tasmaniandroid/Philly_Node/Philly_Node_Lib/DRV0006A.stp

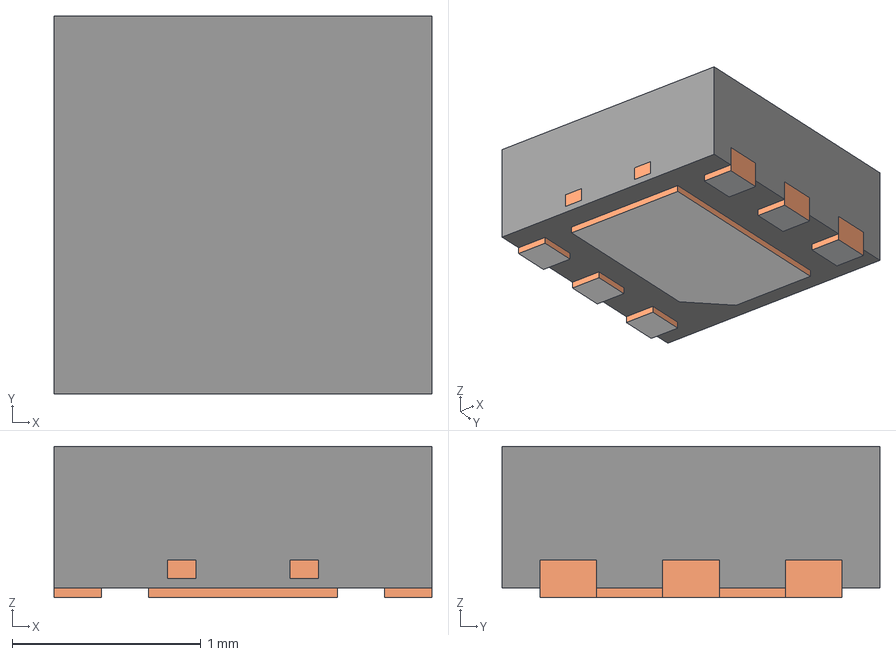
[picture p1: CAD file, 2026-02-25]
Philly_Node_Lib/DRV0006A.stp
2.00 x 2.00 x 0.8 mm
BODY-SON
FRAME-DRV0006A
PIN1-ID
