tasmaniandroid/Philly_Node/Philly_Node_Lib/CC7V-T1A-32.768KHZ-7PF-100PPM-TA-QC.STEP

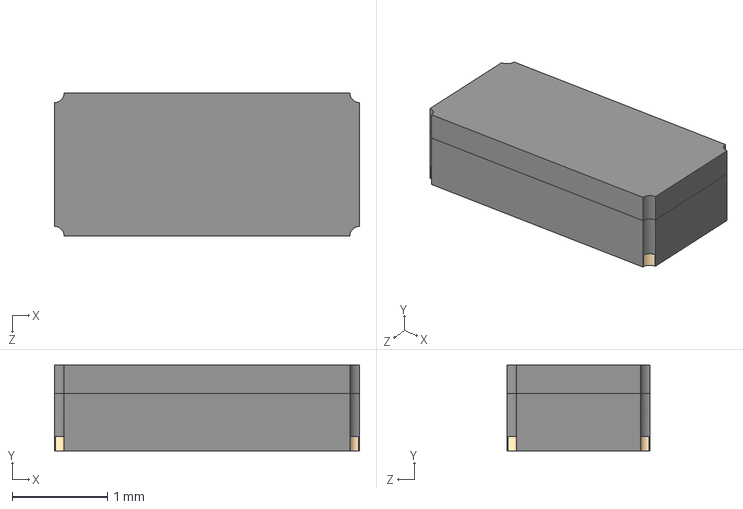
[picture p2: CAD file, 2026-02-14]
Philly_Node_Lib/CC7V-T1A-32.768KHZ-7PF-100PPM-TA-QC.STEP
3.20 x 0.9 x 1.50 mm
