tasmaniandroid/Philly_Node/Philly_Node_Lib/WIRELM-SMD_E22-900M22S.step

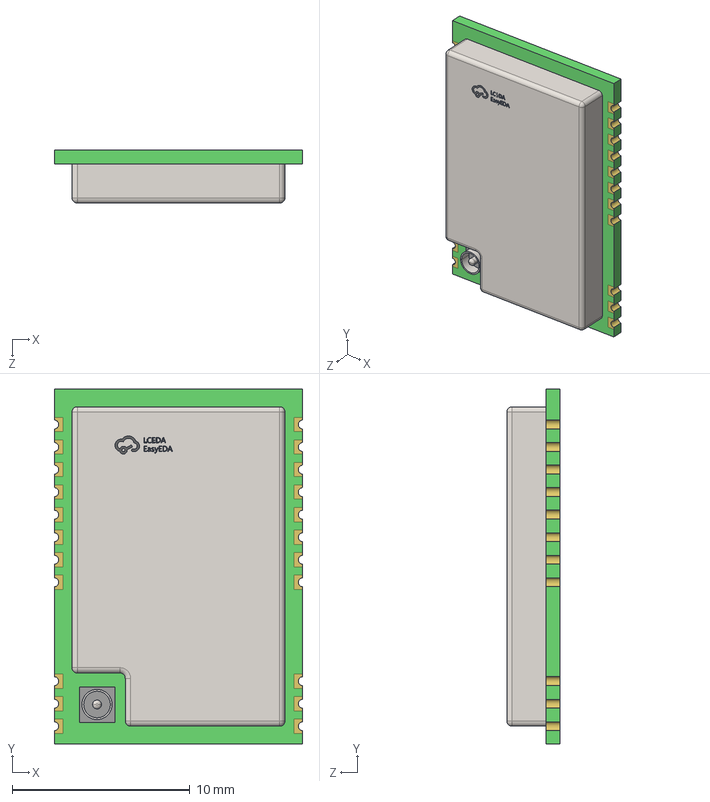
[picture p3: CAD file, 2026-02-14]
Philly_Node_Lib/WIRELM-SMD_E22-900M22S.step
14.0 x 20.0 x 3.00 mm
