tasmaniandroid/Philly_Node/Philly_Node_Lib/LIS2DW12TR.step

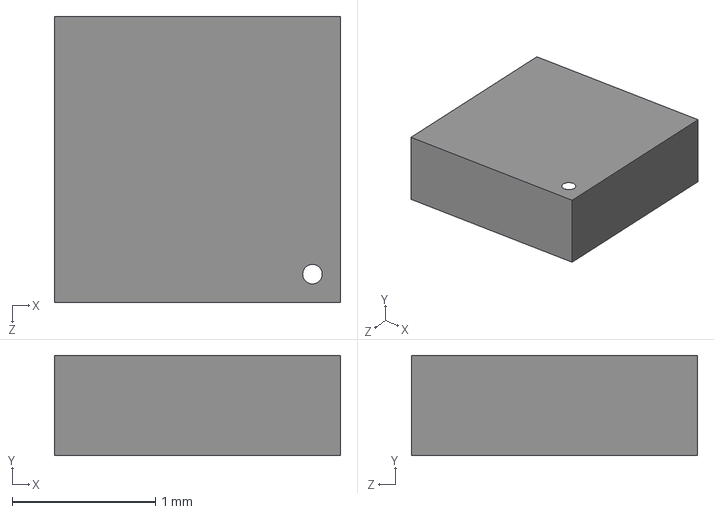
[picture p4: CAD file, 2026-02-14]
Philly_Node_Lib/LIS2DW12TR.step
2.00 x 0.7 x 2.00 mm
