tasmaniandroid/Philly_Node/Philly_Node_Lib/TL3301EF160QJ.stp

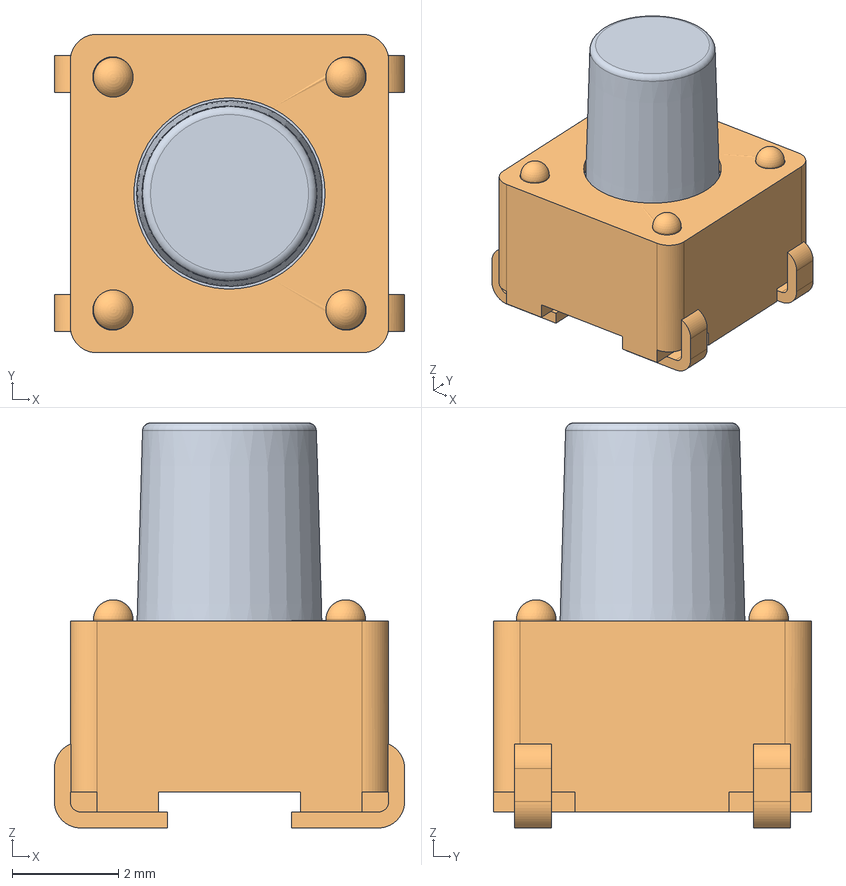
[picture p5: CAD file, 2026-02-14]
Philly_Node_Lib/TL3301EF160QJ.stp
6.60 x 6.00 x 7.63 mm
