tasmaniandroid/Philly_Node/Philly_Node_Lib/F52Q-1A7H1-11020.step

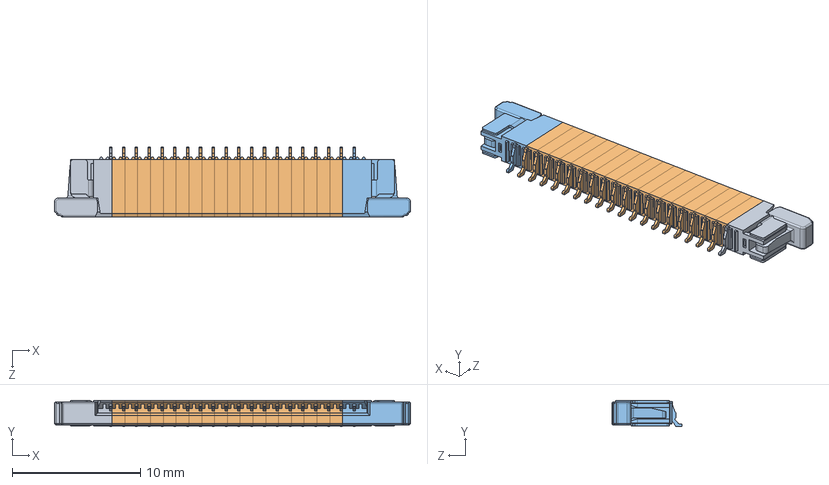
[picture p6: CAD file, 2026-02-14]
Philly_Node_Lib/F52Q-1A7H1-11020.step
27.8 x 2.05 x 5.50 mm
F52Q_L.STEP
F52Q_M.STEP x 18
F52Q_R.STEP
