tasmaniandroid/Philly_Node/Philly_Node_Lib/MDBT50Q-U 3D Drawing_20180620.stp

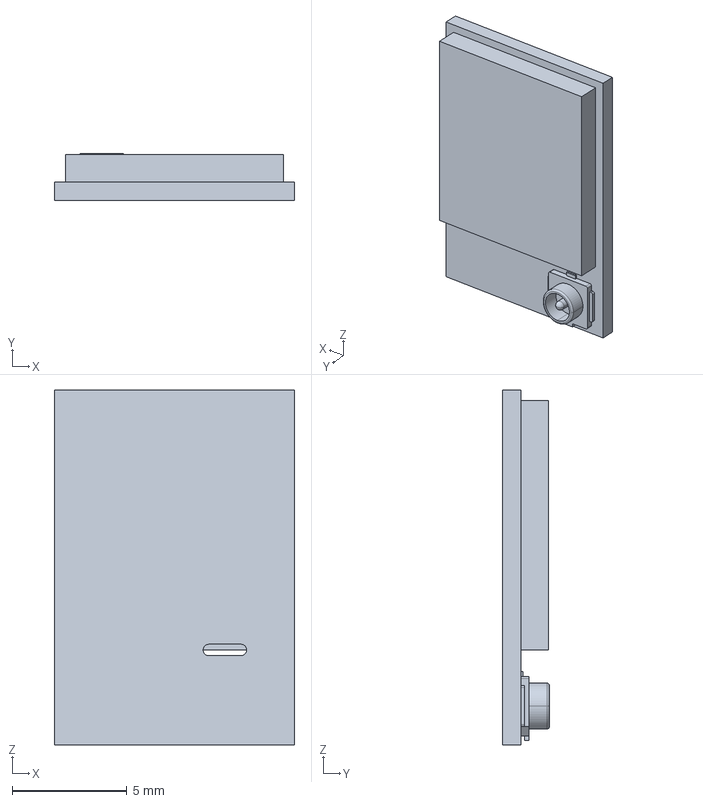
[picture p7: CAD file, 2026-02-14]
Philly_Node_Lib/MDBT50Q-U 3D Drawing_20180620.stp
10.5 x 2.05 x 15.5 mm
