tasmaniandroid/Philly_Node/Philly_Node_Lib/USB4110-GF-A.STEP

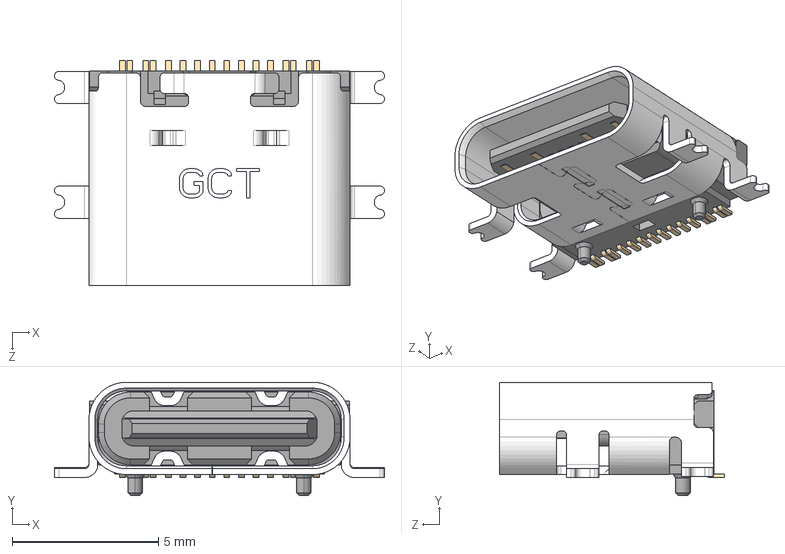
[picture p8: CAD file, 2026-02-14]
Philly_Node_Lib/USB4110-GF-A.STEP
11.3 x 3.89 x 7.70 mm
