tasmaniandroid/Philly_Node/Philly_Node_Lib/XF3M_1_0415_1B.stp

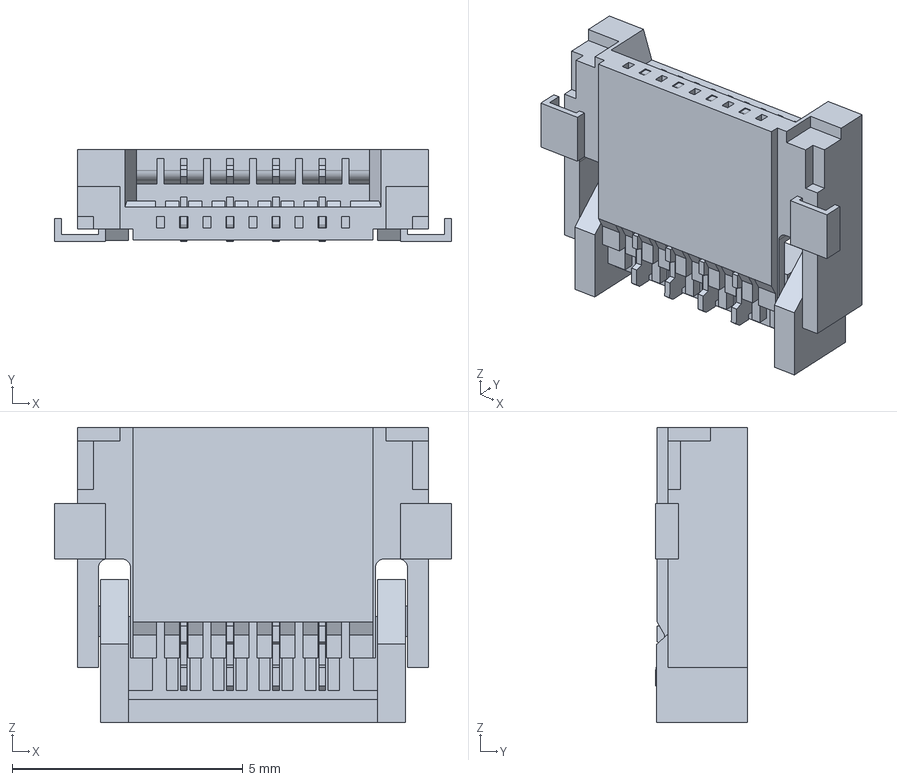
[picture p9: CAD file, 2026-02-14]
Philly_Node_Lib/XF3M_1_0415_1B.stp
8.60 x 2.00 x 6.40 mm
