tasmaniandroid/Philly_Node/Philly_Node_Lib/S2B-PH-SM4-TB.STEP

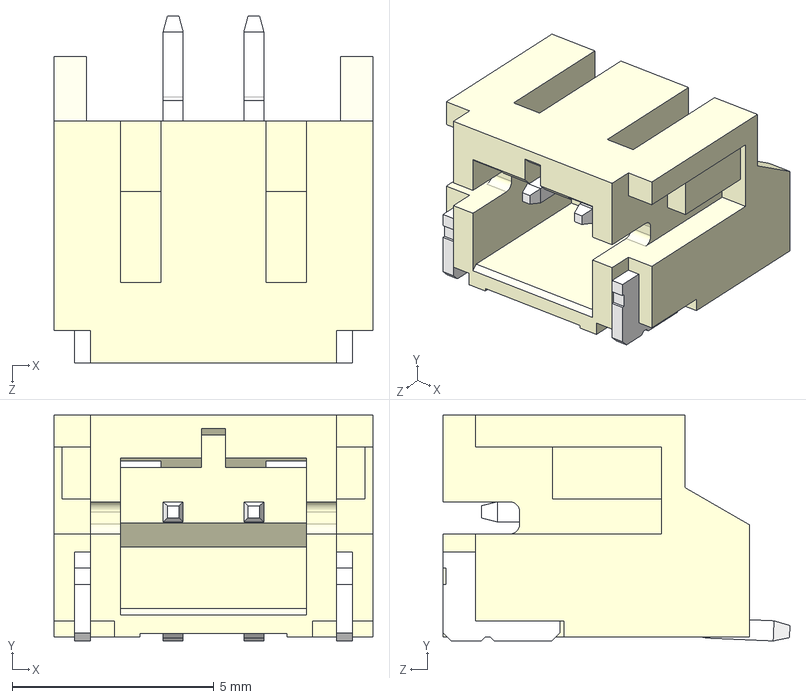
[picture p10: CAD file, 2026-02-14]
Philly_Node_Lib/S2B-PH-SM4-TB.STEP
7.90 x 5.60 x 8.60 mm
