tasmaniandroid/Philly_Node/Philly_Node_Lib/SOD-523_L1.2-W0.8-LS1.6-BI.step

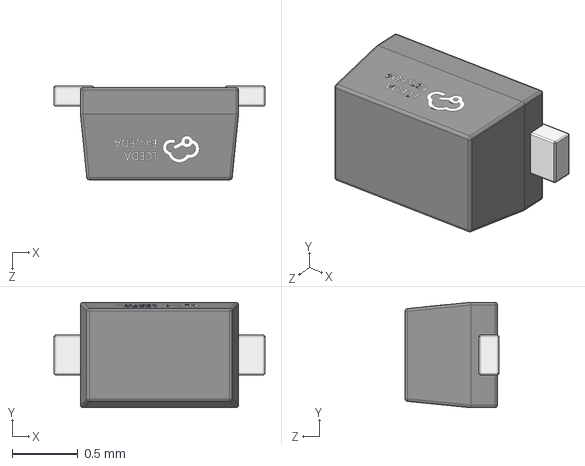
[picture p11: CAD file, 2026-02-14]
Philly_Node_Lib/SOD-523_L1.2-W0.8-LS1.6-BI.step
1.60 x 0.8 x 0.71 mm
