tasmaniandroid/Philly_Node/Philly_Node_Lib/CWJ1.8F160RGBQ.stp

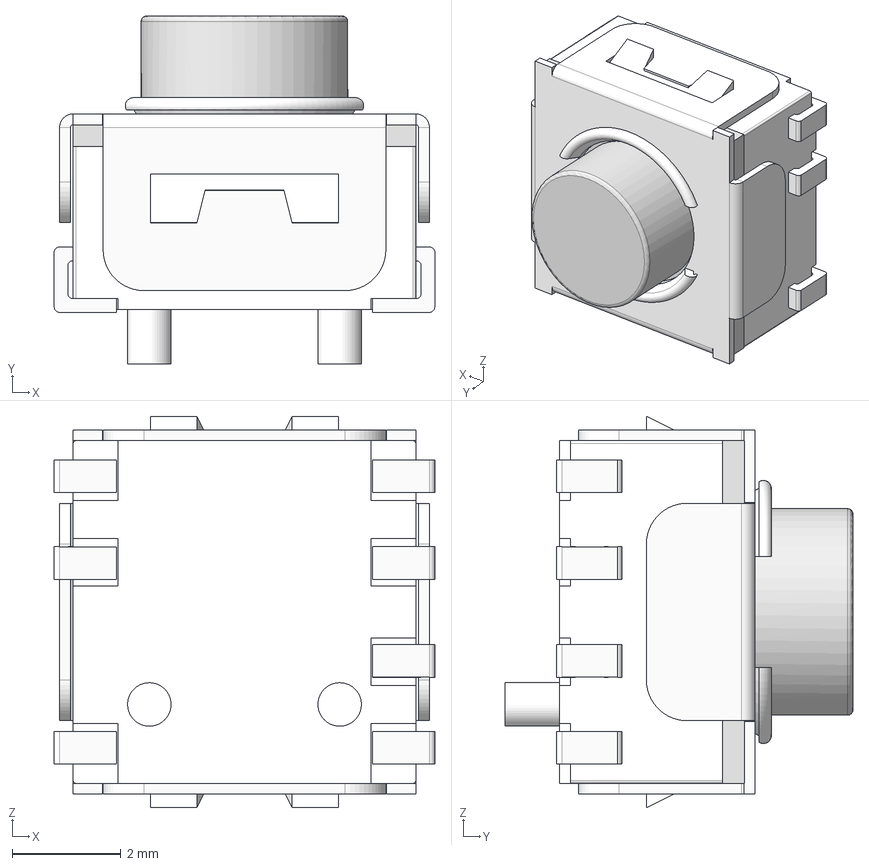
[picture p12: CAD file, 2026-02-14]
Philly_Node_Lib/CWJ1.8F160RGBQ.stp
7.00 x 6.40 x 7.20 mm
Housing
Actuator - 1.8
Cover - Dip
Terminal_J_03-2
Terminal_J_03 x 3
