tasmaniandroid/Philly_Node/Philly_Node_Lib/IS31FL3729-QFLS4-TR.stp

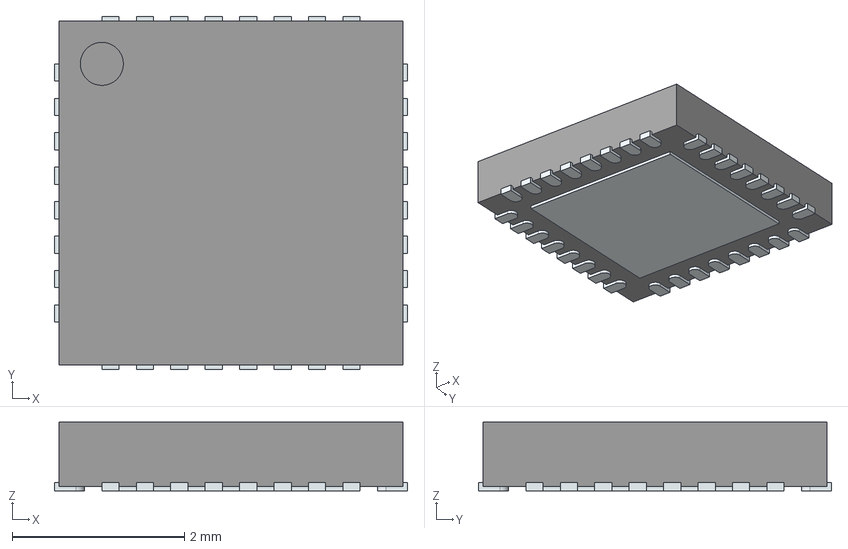
[picture p13: CAD file, 2026-02-14]
Philly_Node_Lib/IS31FL3729-QFLS4-TR.stp
4.10 x 4.10 x 0.8 mm
ThermalPin
PinsArrayLR
PinsArrayTB
