tasmaniandroid/Philly_Node/Philly_Node_Lib/228EMVARGBFR.stp

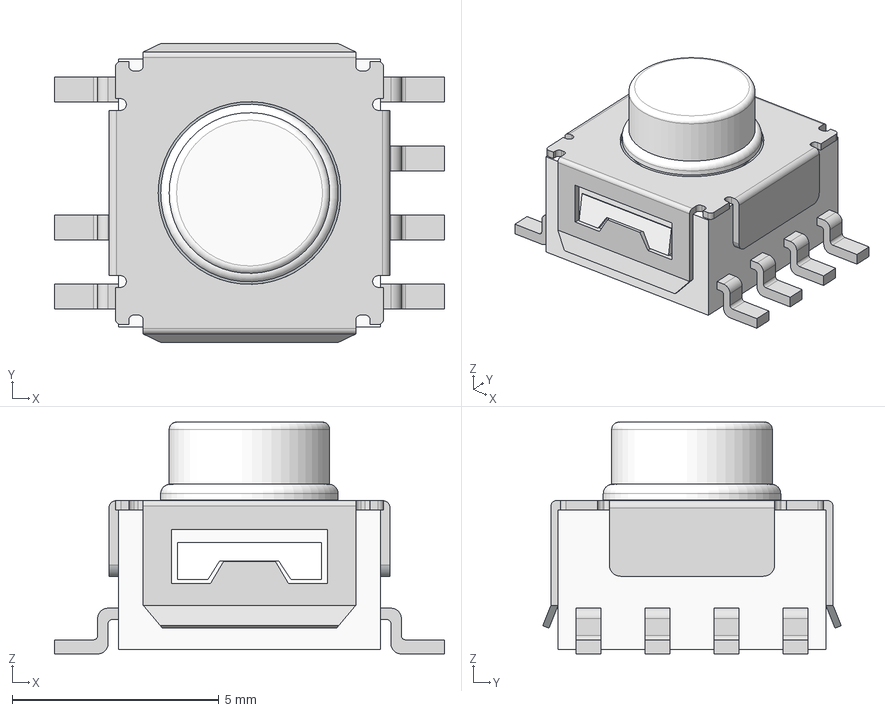
[picture p14: CAD file, 2026-02-14]
Philly_Node_Lib/228EMVARGBFR.stp
9.43 x 7.22 x 5.61 mm
