tasmaniandroid/Philly_Node/Philly_Node_Lib/xf3m_1_-2015-1b.stp

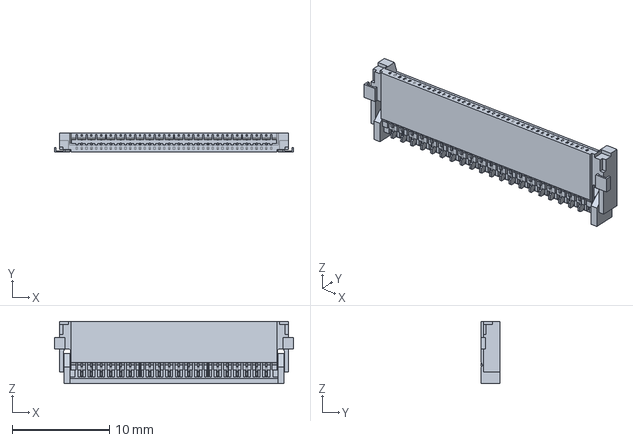
[picture p15: CAD file, 2026-02-14]
Philly_Node_Lib/xf3m_1_-2015-1b.stp
24.6 x 2.00 x 6.40 mm
