tasmaniandroid/Philly_Node/Philly_Node_Lib/BQ25170DSGR.step

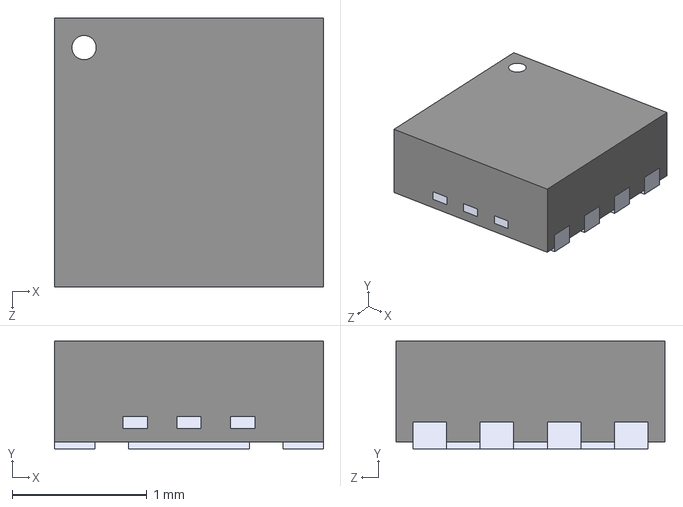
[picture p16: CAD file, 2026-02-14]
Philly_Node_Lib/BQ25170DSGR.step
2.00 x 0.8 x 2.00 mm
