tasmaniandroid/Philly_Node/Philly_Node_Lib/5034802000.step

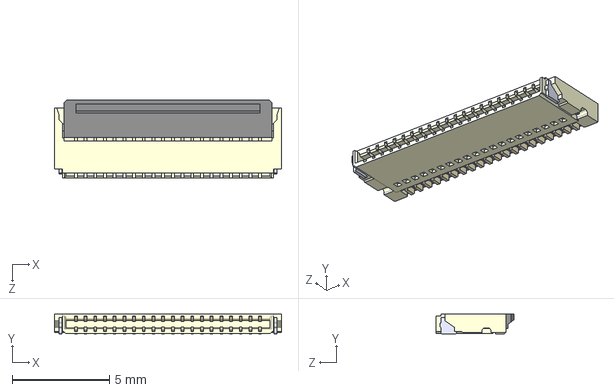
[picture p17: CAD file, 2026-02-14]
Philly_Node_Lib/5034802000.step
11.7 x 1.02 x 4.00 mm
