tasmaniandroid/Philly_Node/Philly_Node_Lib/BQ27531YZFR-G1.step

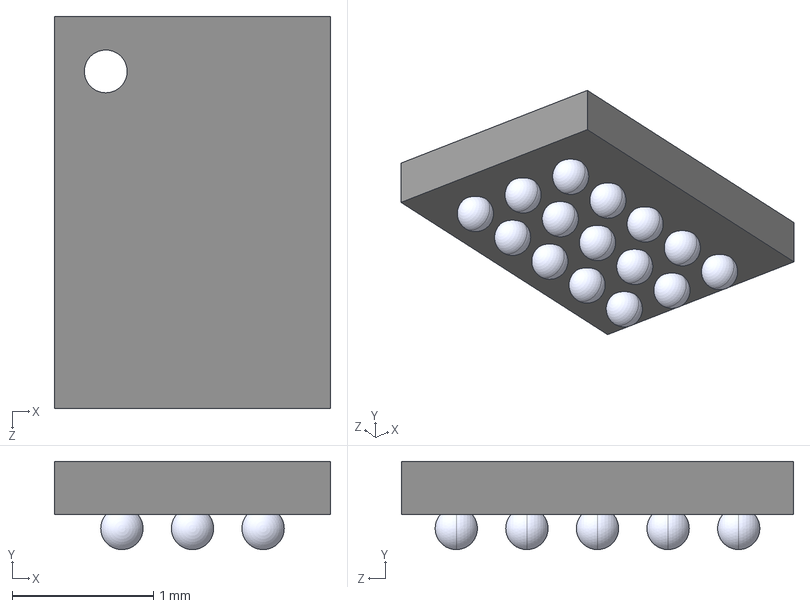
[picture p18: CAD file, 2026-02-14]
Philly_Node_Lib/BQ27531YZFR-G1.step
1.96 x 0.625 x 2.78 mm
