tasmaniandroid/Philly_Node/(list of files, cad)

Other CAD files:
Philly_Node_Lib/5034802000.stp
