tasmaniandroid/Philly_Node/Philly_Node.kicad_pcb

## KiCad design Philly_Node.kicad_pcb (2026-05-05)

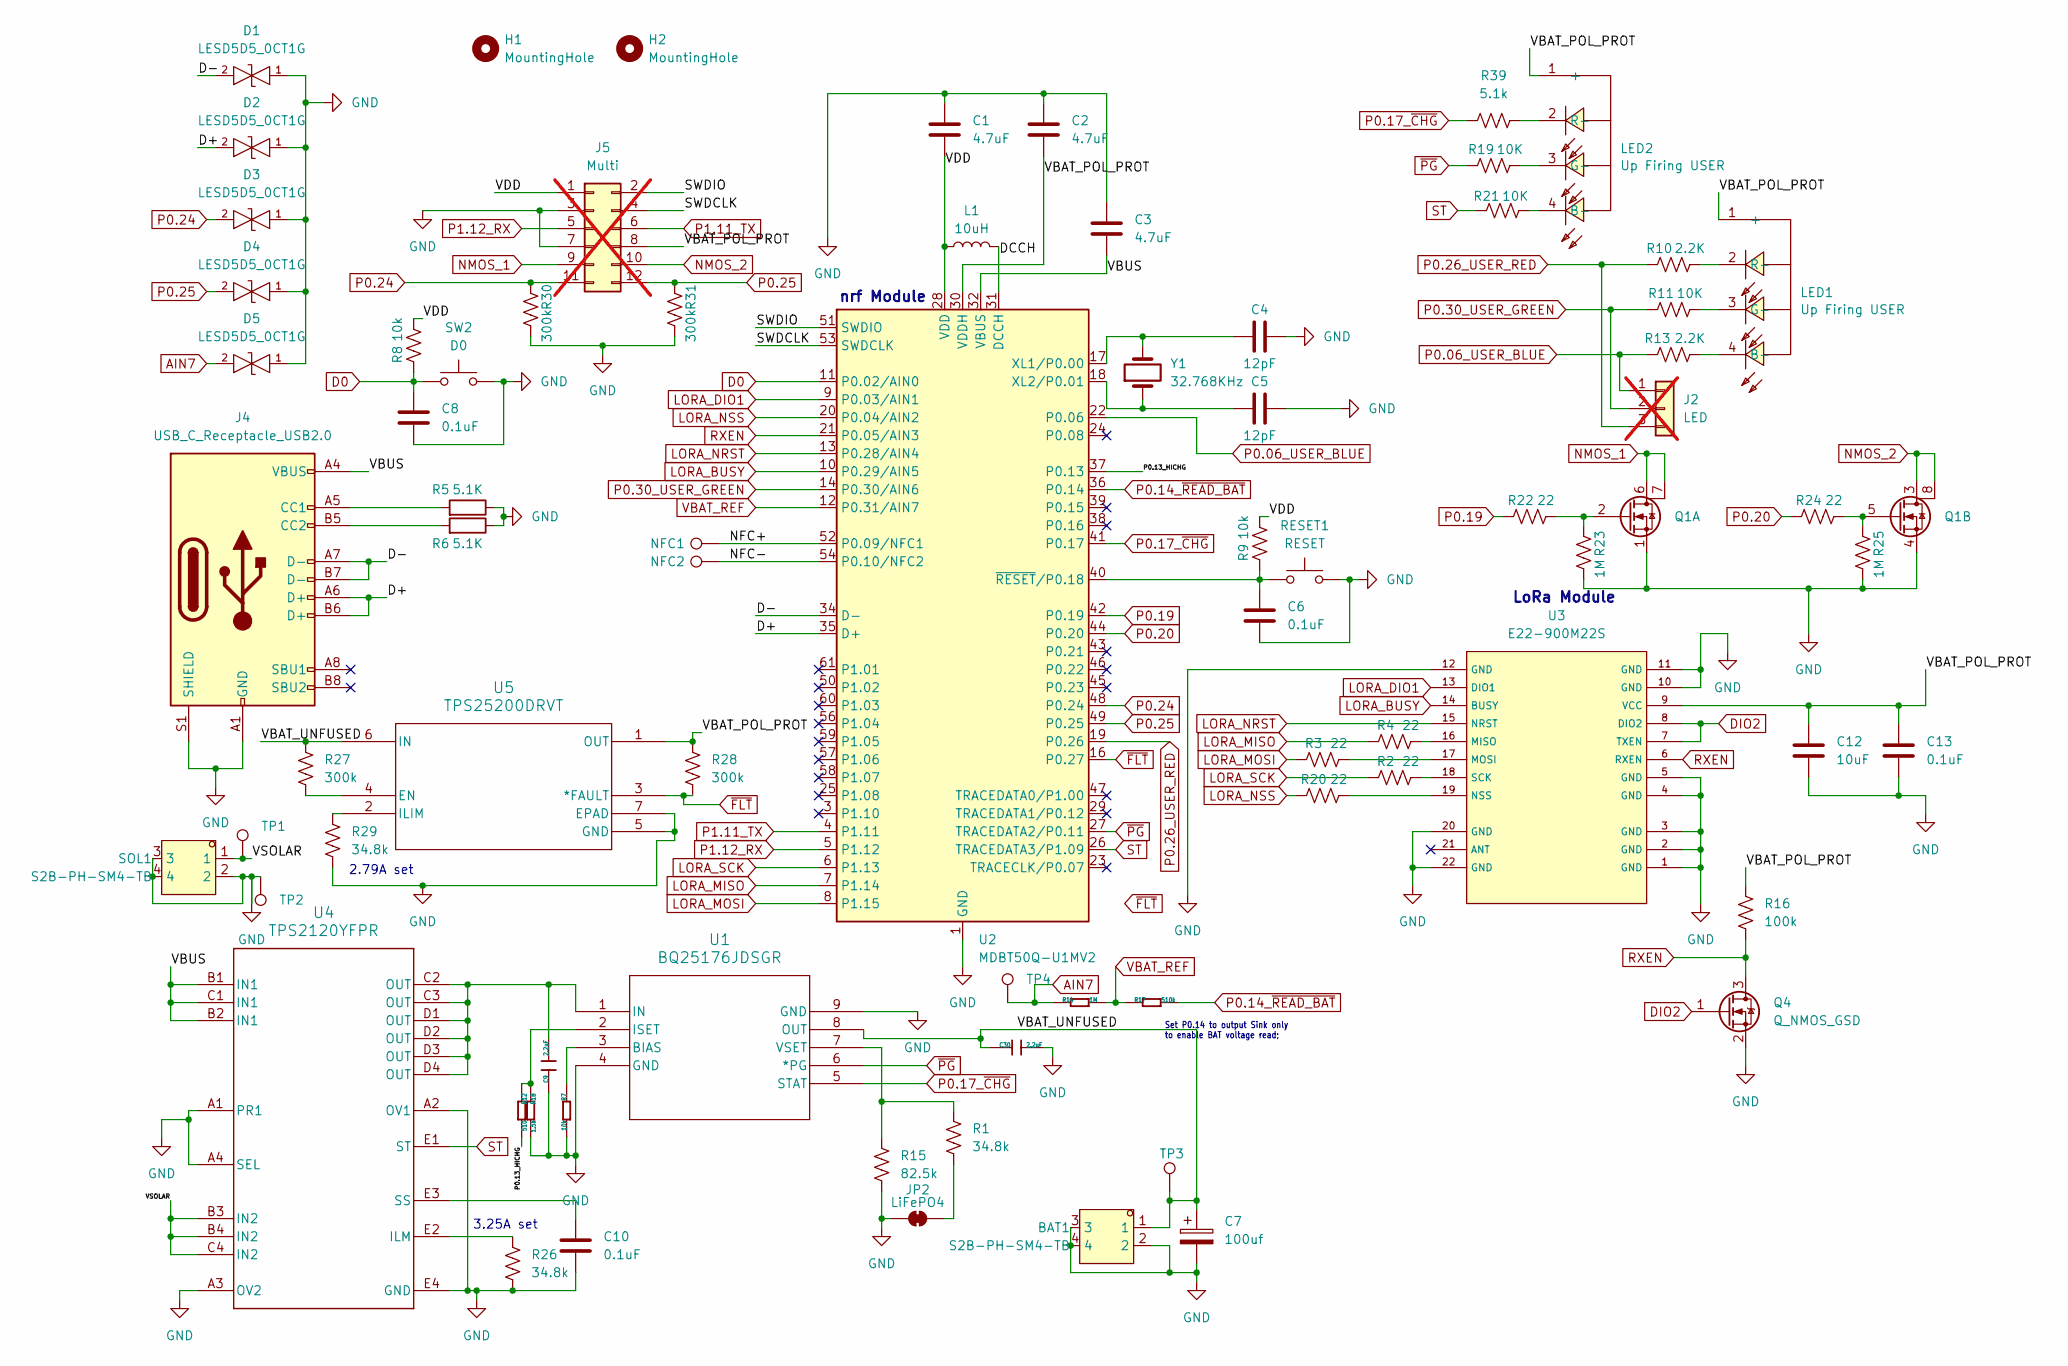
[picture p19: schematic Philly_Node.kicad_sch]

Parts:
BAT1: S2B-PH-SM4-TB; CONN-TH_S2B-PH-K-S-LF-SN; LCSC C968533
C1, C2, C3: 4.7uF; C_0603_1608Metric; LCSC C19666
C4, C5: 12pF; C_0402_1005Metric; LCSC C1547
C6, C8, C10, C13: 0.1uF; C_0402_1005Metric; LCSC C1525
C7: 100uf; CP_Elec_5x4.5; LCSC C72473
C9, C30: 2.2uF; C_0402_1005Metric; LCSC C72203
C12: 10uF; C_0402_1005Metric; LCSC C15525
D1, D2, D3, D4, D5: LESD5D5_0CT1G; SOD-523_L1.2-W0.8-LS1.6-BI; LCSC C383211
H1, H2: MountingHole; MountingHole_2.5mm
J2: LED; PinSocket_1x03_P1.00mm_Vertical; not fitted
J4: USB_C_Receptacle_USB2.0; USB_C_Receptacle_GCT_USB4110_MODIFIED_FOR_PROTRSION; LCSC C34260841
J5: Multi; PinHeader_1x12_P1.27mm_Vertical; not fitted
JP2: LiFePO4; SolderJumper
L1: 10uH; L_0603_1608Metric; LCSC C1035
LED1, LED2: MHPA1010RGBDT; LED-ARRAY-SMD_4P-L1.0-W1.0-TR-RD; LCSC Part C404280
NFC1, NFC2: TestPoint; TestPoint_Pad_D0.75mm
Q1: Q_Dual_NMOS_G1S2G2D2S1D1; DFN-6-1EP_2x2mm_P0.65mm_EP_DUAL; LCSC C22470332
Q4: Q_NMOS_GSD; SOT-23-3; LCSC C20917
R1, R26, R29: 34.8k; R_0402_1005Metric; LCSC C47493
R2, R3, R4, R20, R22, R24: 22; R_0402_1005Metric; LCSC C25152
R5, R6: 5.1K; R_0402_1005Metric; LCSC C25905
R7, R8, R9: 10k; R_0402_1005Metric; LCSC C25744
R10, R13: 2.2K; R_0402_1005Metric; LCSC C25879
R11, R19, R21: 10K; R_0402_1005Metric; LCSC C25744
R12: 510; R_0402_1005Metric; LCSC C25123
R14, R23, R25: 1M; R_0402_1005Metric; LCSC C26083
R15: 82.5k; R_0402_1005Metric; LCSC C11717
R16: 100k; R_0402_1005Metric; LCSC C25741
R17: 510k; R_0402_1005Metric; LCSC C11616
R18: 1.5k; R_0402_1005Metric; LCSC C25867
R27, R28, R30, R31: 300k; R_0402_1005Metric; LCSC C270412
R39: 5.1k; R_0402_1005Metric; LCSC C25905
RESET1: RESET; SW_Tactile_SPST_NO_Straight_TVAF44-N015C-R; LCSC C19270949
SOL1: S2B-PH-SM4-TB; CONN-TH_S2B-PH-K-S-LF-SN; LCSC C47647
SW2: D0; SW_Tactile_SPST_NO_Straight_TVAF44-N015C-R; LCSC C19270949
TP1, TP2, TP3, TP4: TestPoint; TestPoint_Pad_1.0x1.0mm
U1: BQ25176JDSGR; WSON_MDSGR_TEX; LCSC C22407142
U2: MDBT50Q-U1MV2; Raytac_MDBT50Q; LCSC C2688382
U3: E22-900M22S; WIRELM-SMD_E22-900M22S; LCSC C411293
U4: TPS2120YFPR; YFP0020AAAA; LCSC C1850326
U5: TPS25200DRVT; DRV6_1X1P6_TEX; LCSC C128401
Y1: 32.768KHz; Crystal_SMD_MicroCrystal_CC7V-T1A-2Pin_3.2x1.5mm; LCSC C32346

Connections:
/D+: D2.2, J4.A6 (D+), J4.B6 (D+), U2.35 (D+)
/D-: D1.2, J4.A7 (D-), J4.B7 (D-), U2.34 (D-)
/DCCH: L1.2, U2.31 (DCCH)
/NFC+: NFC1.1, U2.52 (P0.09/NFC1)
/NFC-: NFC2.1, U2.54 (P0.10/NFC2)
/P0.13_HICHG: R12.2, U2.37 (P0.13)
/SWDCLK: J5.4, U2.53 (SWDCLK)
/SWDIO: J5.2, U2.51 (SWDIO)
/VBAT_POL_PROT: C2.2, C12.1, C13.1, J5.8, LED1.1 (+), LED2.1 (+), R16.1, R28.1, U2.30 (VDDH), U3.9 (VCC), U5.1 (OUT)
/VBAT_UNFUSED: BAT1.1, C7.1, C30.1, R27.1, TP3.1, U1.8 (OUT), U5.6 (IN)
/VBUS: C3.2, J4.A4 (VBUS), J4.A9 (VBUS), J4.B4 (VBUS), J4.B9 (VBUS), U2.32 (VBUS), U4.B1 (IN1), U4.B2 (IN1), U4.C1 (IN1)
/VDD: C1.2, J5.1, L1.1, R8.2, R9.2, U2.28 (VDD)
/VSOLAR: SOL1.1, TP1.1, U4.B3 (IN2), U4.B4 (IN2), U4.C4 (IN2)
AIN7: D5.2, R14.1, TP4.1
D0: C8.1, R8.1, SW2.1, U2.11 (P0.02/AIN0)
DIO2: Q4.1 (G), U3.7 (TXEN), U3.8 (DIO2)
GND: BAT1.2, BAT1.3, BAT1.4, C1.1, C2.1, C3.1, C4.2, C5.1, C6.2, C7.2, C8.2, C9.1, C10.2, C12.2, C13.2, C30.2, D1.1, D2.1, D3.1, D4.1, D5.1, J4.A1 (GND), J4.A12 (GND), J4.B1 (GND), J4.B12 (GND), J4.S1 (SHIELD), J5.3, J5.7, JP2.1 (A), Q1.1 (S), Q1.4 (S), Q4.2 (S), R5.1, R6.1, R7.2, R15.2, R18.2, R23.2, R25.2, R26.2, R29.2, R30.2, R31.2, RESET1.2, SOL1.2, SOL1.3, SOL1.4, SW2.2, TP2.1, U1.4 (GND), U1.9 (GND), U2.1 (GND), U2.2 (GND), U2.15 (GND), U2.33 (GND), U2.55 (GND), U3.1 (GND), U3.2 (GND), U3.3 (GND), U3.4 (GND), U3.5 (GND), U3.10 (GND), U3.11 (GND), U3.12 (GND), U3.20 (GND), U3.22 (GND), U4.A1 (PR1), U4.A2 (OV1), U4.A3 (OV2), U4.A4 (SEL), U4.E4 (GND), U5.5 (GND), U5.7 (EPAD)
LORA_BUSY: U2.10 (P0.29/AIN5), U3.14 (BUSY)
LORA_DIO1: U2.9 (P0.03/AIN1), U3.13 (DIO1)
LORA_MISO: R4.1, U2.7 (P1.14)
LORA_MOSI: R3.1, U2.8 (P1.15)
LORA_NRST: U2.13 (P0.28/AIN4), U3.15 (NRST)
LORA_NSS: R20.1, U2.20 (P0.04/AIN2)
LORA_SCK: R2.1, U2.6 (P1.13)
NMOS_1: J5.9, Q1.6 (D), Q1.7 (D)
NMOS_2: J5.10, Q1.3 (D), Q1.8 (D)
unnamed: J4.A5 (CC1), R5.2
unnamed: J4.B5 (CC2), R6.2
unnamed: JP2.2 (B), R1.2
unnamed: LED1.4 (B-), R13.2
unnamed: LED1.3 (G-), R11.2
unnamed: LED1.2 (R-), R10.2
unnamed: LED2.4 (B-), R21.2
unnamed: LED2.3 (G-), R19.2
unnamed: LED2.2 (R-), R39.2
unnamed: Q1.2 (G), R22.2, R23.1
unnamed: Q1.5 (G), R24.2, R25.1
unnamed: R7.1, U1.3 (BIAS)
unnamed: C9.2, U1.1 (IN), U4.C2 (OUT), U4.C3 (OUT), U4.D1 (OUT), U4.D2 (OUT), U4.D3 (OUT), U4.D4 (OUT)
unnamed: R12.1, R18.1, U1.2 (ISET)
unnamed: R1.1, R15.1, U1.7 (VSET)
unnamed: C4.1, U2.17 (XL1/P0.00), Y1.2
unnamed: C5.2, U2.18 (XL2/P0.01), Y1.1
unnamed: C6.1, R9.1, RESET1.1, U2.40 (~RESET/P0.18)
unnamed: R4.2, U3.16 (MISO)
unnamed: R3.2, U3.17 (MOSI)
unnamed: R20.2, U3.19 (NSS)
unnamed: R2.2, U3.18 (SCK)
unnamed: R26.1, U4.E2 (ILM)
unnamed: C10.1, U4.E3 (SS)
unnamed: R27.2, U5.4 (EN)
unnamed: R29.1, U5.2 (ILIM)
P0.06_USER_BLUE: J2.1, R13.1, U2.22 (P0.06)
P0.14_~READ_BAT: R17.2, U2.36 (P0.14)
P0.17_~CHG: R39.1, U1.5 (STAT), U2.41 (P0.17)
P0.19: R22.1, U2.42 (P0.19)
P0.20: R24.1, U2.44 (P0.20)
P0.24: D3.2, J5.11, R30.1, U2.48 (P0.24)
P0.25: D4.2, J5.12, R31.1, U2.49 (P0.25)
P0.26_USER_RED: J2.3, R10.1, U2.19 (P0.26)
P0.30_USER_GREEN: J2.2, R11.1, U2.14 (P0.30/AIN6)
P1.11_TX: J5.6, U2.4 (P1.11)
P1.12_RX: J5.5, U2.5 (P1.12)
RXEN: Q4.3 (D), R16.2, U2.21 (P0.05/AIN3), U3.6 (RXEN)
ST: R21.1, U2.26 (TRACEDATA3/P1.09), U4.E1 (ST)
VBAT_REF: R14.2, R17.1, U2.12 (P0.31/AIN7)
~FLT: R28.2, U2.16 (P0.27), U5.3 (*FAULT)
~PG: R19.1, U1.6 (*PG), U2.27 (TRACEDATA2/P0.11)

Notes on the sheet:
2.79A set
3.25A set
nrf Module
Set P0.14 to output Sink only to enable BAT voltage read;
LoRa Module

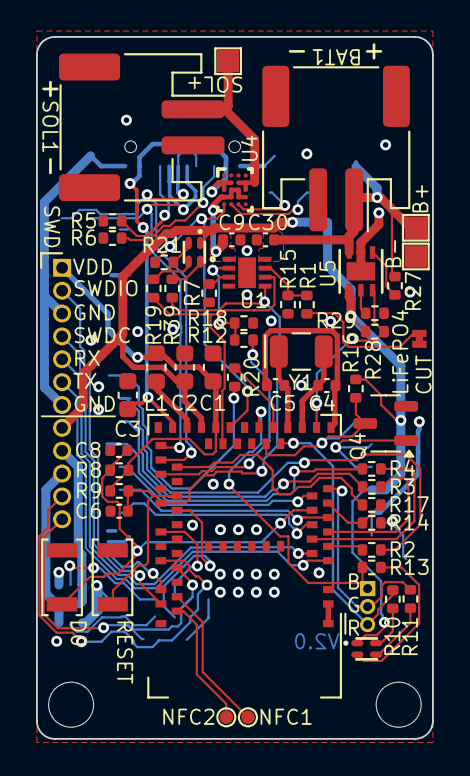
[picture p20: board Philly_Node.kicad_pcb from above]

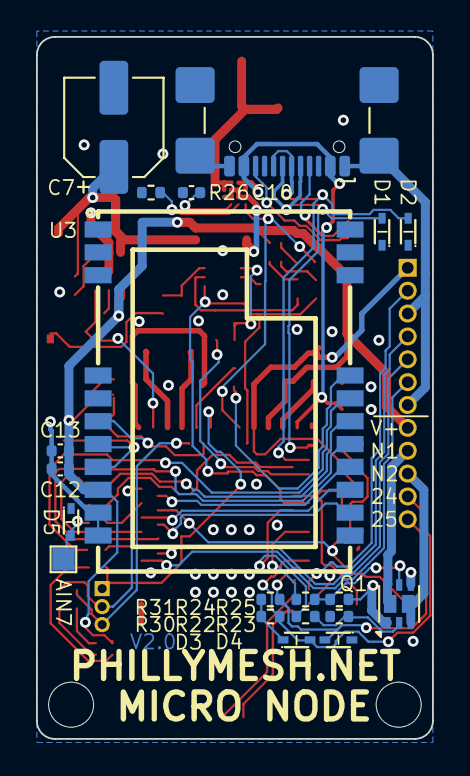
[picture p21: board Philly_Node.kicad_pcb from below]

Board: 2 copper layers, 22.0 x 39.0 mm, 77 parts (20 on the bottom side), 68 nets.
