tasmaniandroid/Philly_Node/(commit log)

2026-01-28 Initial commit of nrf based micro node.
    [Philly_Node.kicad_pcb, Philly_Node.kicad_sch]
2026-02-10 Nearly done, final part number checks needed.
    [Philly_Node.kicad_pcb, Philly_Node.kicad_sch]
2026-02-12 Added D0 button, NFC pads, and library files.
    [Philly_Node.kicad_pcb, Philly_Node.kicad_sch]
2026-02-12 Added courtyards, updated schematic to point to local lib footprints.
    [Philly_Node.kicad_pcb, Philly_Node.kicad_sch]
2026-02-14 changed to BQ25176JDSGR charge IC
    [228EMVARGBFR.stp, 5034802000.step, 5034802000.stp, BQ25170DSGR.step, BQ27531YZFR-G1.step, CC7V-T1A-32.768KHZ-7PF-100PPM-TA-QC.STEP, CWJ1.8F160RGBQ.stp, F52Q-1A7H1-11020.step]
2026-02-25 Changes to powerpath, added test points for battery/solar, misc other.
    [DRV0006A.stp, Philly_Node.kicad_pcb, Philly_Node.kicad_sch]
2026-03-17 Production order. Changed to Amphenol USB-C connector from clone.
    [Philly_Node.kicad_pcb, Philly_Node.kicad_sch]
2026-04-27 Adjustments to routing, added in more signals for solar input detection.
    [Philly_Node.kicad_pcb, Philly_Node.kicad_sch]
2026-04-29 Silkscreen and version number bump
    [Philly_Node.kicad_pcb]
2026-05-05 Add 2 user inputs with ESD diodes, break out old analog battery voltage monitor pin.
    [Philly_Node.kicad_pcb, Philly_Node.kicad_sch]
